cabeese/crab-tracker/README.md

# crab-tracker
Track invasive crab species via acoustic signals.
