cabeese/crab-tracker/doc/Template-RFC.tex

\documentclass[12pt]{article}

\setlength{\parindent}{0pt}
\setlength{\parskip}{2mm}

\usepackage{geometry}
 \geometry{
 letterpaper, left=20mm, right=20mm,  top=20mm,
 }
\usepackage{graphicx}
\graphicspath{ {graphics/} }
\usepackage{amssymb}

%%%%%%%%%%%%%%%%%%%%%%%%%%%%%%%%%%%%%%%%%%%%%%%%%
\title{RFC (n) - (Description)}
%%%%%%%%%%%%%%%%%%%%%%%%%%%%%%%%%%%%%%%%%%%%%%%%%

\author{
	Margot Maxwell \and
	Lizzy Schoen \and
	Noah Strong \and
	Chloe Yugawa
}

\date{\today\ -- v1.0-wip}

\begin{document}

\maketitle

\tableofcontents{}

\section{Introduction}

\section{Background}

\end{document}
