cabeese/crab-tracker/doc/TriangulationAlgorithm/triangulation_error.pdf

# Triangulation Error

Chloe Yugawa

June 2018

The below graph created from the data in the table show the error for algorithm output with different levels of precision. Data points are generated from -10 to 10 meters away from the center of the system along the x and y coordinates and from -3 to -10 meters along the z axis every half meter, generating over 25,000 data points. Time stamps are calculated in microseconds for each coordinate, and fed into the triangulation algorithm. The error graph includes percent of points where N, or distance from the middle of the hydrophones to the crab is off by more than 5 meters. N is used because it is less precise than angle measurement theta and both r and z are dependent on N. For microsecond errors (highlighted in red in the table, and on the left side of the graph), a random number between the positive and negative error listed in the table is added to each time stamp. At 0ns, the time stamps are precise down to the microsecond without regard for nanoseconds. Past that, data is precise up to the number of nanoseconds listed.

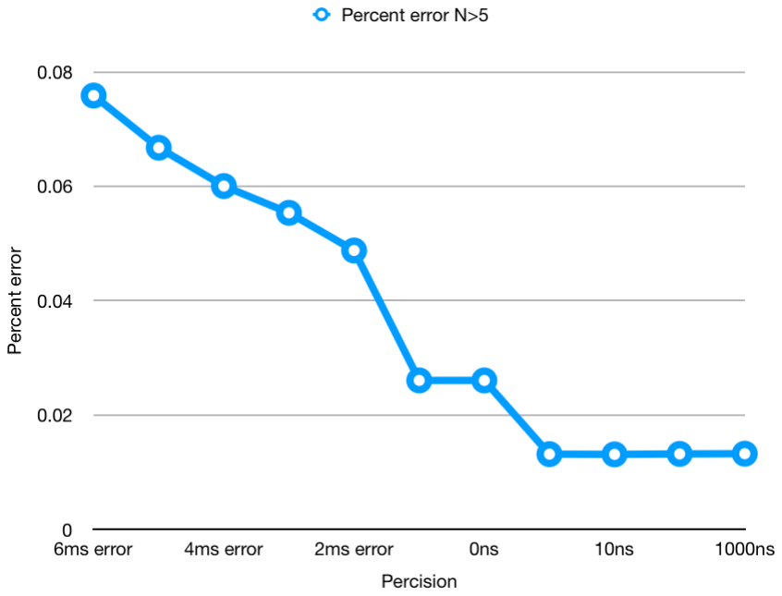
[picture p35: figure]

Figure 1: Graphed Error

Table 1: Error data
Precision | Percent error N>5
6µs error | 0.075868
5µs error | 0.066746
4µs error | 0.060044
3µs error | 0.055364
2µs error | 0.048780
1µs error | 0.026056
0ns | 0.026056
1ns | 0.013167
10ns | 0.013127
100ns | 0.013206
1000ns | 0.013246

1
