cabeese/crab-tracker/doc/TriangulationAlgorithm/TriangulationAlgorithm.pdf

# Triangulation Algorithm

Chloe Yugawa

February 2018

This algorithm is designed to calculate the location of a signal received by four hydrophones, all of which are equally spaced from each other in a square that is parallel to the surface of the water. To calculate the location of the signal origin, we will use the time stamps from each hydrophone (the time at which the signal was received), the speed of sound in the given environment, and some basic algebra and trigonometry. First, we write equations for the time it takes the signal to reach each hydrophone (labelled a,b,c, and d) using the formula for the distance between two points times the speed of sound in water (s). The origin is defined as the center of the hydrophone square, and l is defined as both the x and y distances from the origin to each hydrophone.
s = speed of sound through water
l = x and y distance from origin to each hydrophone
a = hydrophone at location (l, l)
b = hydrophone at location (−l, l)
c = hydrophone at location (−l, −l)
d = hydrophone at location (l, −l)
ta = time stamp of signal for hydrophone a tb = time stamp of signal for hydrophone b tc = time stamp of signal for hydrophone c td = time stamp of signal for hydrophone d

ta =

1
s

∗

p
(x − l)

2 + (y − l)

2 + z

2

tb =

1
s

∗

p
(x + l)

2 + (y − l)

2 + z

2

tc =

1
s

∗

p
(x + l)

2 + (y + l)

2 + z

2

td =

1
s

∗

p
(x − l)

2 + (y + l)

2 + z

2

Now, we define the deltas, or time differences. For this algorithm, hydrophone a has been chosen to be the reference. Calculating in terms of a different hydrophone would work equivalently.

delta1 = tb − ta =

1
s

∗

p
(x + l)

2 + (y − l)

2 + z

2 − s ∗

p
(x − l)

2 + (y − l)

2 + z

2

delta2 = tc − ta =

1
s

∗

p
(x + l)

2 + (y + l)

2 + z

2 − s ∗

p
(x − l)

2 + (y − l)

2 + z

2

delta3 = td − ta =

1
s

∗

p
(x − l)

2 + (y + l)

2 + z

2 − s ∗

p
(x − l)

2 + (y − l)

2 + z

2

These equations rewritten for clarity and for future steps:

delta1 =

1
s

(

p
(x + l)

2 + (y − l)

2 + z

2 −

p
(x − l)

2 + (y − l)

2 + z

2)

delta2 =

1
s

(

p
(x + l)

2 + (y + l)

2 + z

2 −

p
(x − l)

2 + (y − l)

2 + z

2)

delta3 =

1
s

(

p
(x − l)

2 + (y + l)

2 + z

2 −

p
(x − l)

2 + (y − l)

2 + z

2)

1

With 2s factored out and the distance to hydrophone a moved to the other side of the equations, we get:

delta1 ∗ s +

p
(x − l)

2 + (y − l)

2 + z

2 =

p
(x + l)

2 + (y − l)

2 + z

2

delta2 ∗ s +

p
(x − l)

2 + (y − l)

2 + z

2 =

p
(x + l)

2 + (y + l)

2 + z

2

delta3 ∗ s +

p
(x − l)

2 + (y − l)

2 + z

2 =

p
(x − l)

2 + (y + l)

2 + z

2

Squaring both sides and simplifying yields

(delta1 ∗ s)

2 + (x − l)

2 + (y − l)

2 + z

2 + delta1 ∗ s ∗

p
(x − l)

2 + (y − l)

2 + z

2 = (x + l)

2 + (y − l)

2 + z

2

(delta2 ∗ s)

2 + (x − l)

2 + (y − l)

2 + z

2 + delta2 ∗ s ∗

p
(x − l)

2 + (y − l)

2 + z

2 = (x + l)

2 + (y + l)

2 + z

2

(delta3 ∗ s)

2 + (x − l)

2 + (y − l)

2 + z

2 + delta3 ∗ s ∗

p
(x − l)

2 + (y − l)

2 + z

2 = (x − l)

2 + (y + l)

2 + z

2

Note that the only known values are the s and time stamps and thus the value of the deltas. Further simplification:
(delta1 ∗ s)

2 + delta1 ∗ s ∗

p
(x − l)

2 + (y − l)

2 + z

2 = 4lx | (1)

(delta2 ∗ s)

2 + delta2 ∗ s ∗

p
(x − l)

2 + (y − l)

2 + z

2 = 4lx + 4ly | (2)

(delta3 ∗ s)

2 + delta3 ∗ s ∗

p
(x − l)

2 + (y − l)

2 + z

2 = 4ly | (3)

Here, we see (2) is a linear combination of (1) and (3), and that the term p (x − l)

2 + (y − l)

2 + z

| 2 shows
up in all three equations. To solve this equation, set p (x − l)

2 + (y − l)

2 + z

2 = N.

(delta1 ∗ s)

2 + delta1 ∗ s ∗ N = 4lx | (4)

(delta2 ∗ s)

2 + delta2 ∗ s ∗ N = 4lx + 4ly | (5)

(delta3 ∗ s)

2 + delta3 ∗ s ∗ N = 4ly | (6)

Now, using the fact that the equations are linear combinations, we get (4) + (6) = (5):

(delta1 ∗ s)

2 + delta1 ∗ s ∗ N + (delta3 ∗ s)

2 + delta3 ∗ s ∗ N = (delta2 ∗ s)

2 + delta2 ∗ s ∗ N

Solving for N:

N =

s(delta²
2 − delta²
1 − delta²
3

)
2(delta1 + delta3 − delta2)

Solving (4) for x and (6) for y and using N which is now in terms of known values, we get

x =

(s ∗ delta1)

2 + 2s ∗ delta1 ∗ N
4l

y =

(s ∗ delta3)

2 + 2s ∗ delta3 ∗ N
4l

To find z, we go back to N =

p
(x − l)

2 + (y − l)

2 + z

2. We now have equations for N, x, and y, so we just need to solve this for z:
z =

p
N² − (x − l)

2 − (y − l)

2

The last calculations to do are translating the Cartesian coordinates into polar coordinates. Per the software requirements, angle measurements will be in degrees. z is the same in both coordinate systems, so the only values to find are radius r and angle θ.

r =

p
x

2 + y

2
θ = tanh ( y
x

) ∗

180
π

2
