cabeese/crab-tracker/GUI/radar.png

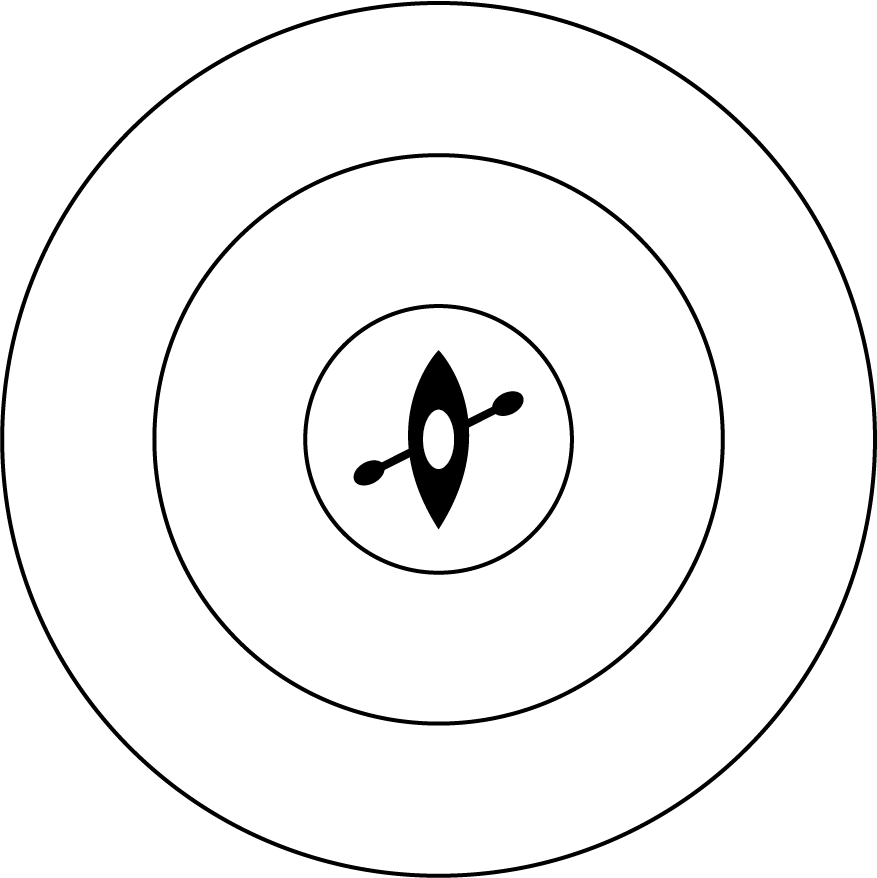
GUI/radar.png
