cabeese/crab-tracker/doc/TechnicalUserGuide/building.md

To create the glossary, first run PDFLaTeX, as usual.
Then, run
      makeglossaries main
Then run PDFLaTeX again.
