cabeese/crab-tracker/(threads)

Thread 2 (2017-11-04):

Statistical analysis - likelihood of collisions

cabeese, 2017-11-04:
We want to know the statistical likelihood of transmission collisions given various crab densities, broadcast encoding lengths, and interval lengths. We'd like to know how varying any one of these values affects the expected number of collisions within a given period of time.

For example, if we expect to have 3 crabs in the detection radius at any given time, what's the probability that two of them will transmit at the same time? (Where "same time" just means that their broadcasts interfere in any way.) How would that probability change if we extended the average time between broadcasts?

This seems related to the birthday problem:
https://betterexplained.com/articles/understanding-the-birthday-paradox/

It would be lovely to have a discussion of this in the RFC 1 document or else on its own somewhere.

chloeyugawa, 2017-11-29:
@cabeese Please add some sample numbers (e.g. interval time, etc.) so we can have some more-realistic calculations.

cabeese, 2017-12-14:
Here are some numbers that may be helpful and more in line with what we use in the project. Please forgive my shorthand notation.

### Rough estimates
* The **target listening radius** (aka the "**detection radius**") we're shooting for is about 50m.
* The **length of a signal**, from the rising edge of the first ping to the falling edge of the second ping, _is very much subject to change_ as the project progresses. However, for the time being, let's use the following numbers (derived below): 11ms to 1511ms.
* The **interval time**, defined as the time between consecutive broadcasts by a single transmitter*, is a randomly-varying value that will be recalculated between each broadcast. Currently, that value is expected to range between 20 and 30 seconds. _This, too, is subject to change_.

### Calculation of signal length
Pings should be a minimum of 1ms, and the space between rising edges must be no less than 10ms. The "step size" for ID encoding could be 0.1ms (see the equation below).

We'll assume `ping_duration = (1 + ID)ms` and `delay = (10 + 2*ID)ms`. Delay is calculated between rising edges, so one signal's length would be `ping + (delay-ping) + ping`, or just `ping + delay`. Therefore the min length of the whole signal would be `ping(0) + delay(0) = 1ms + 10ms = 11ms`, and the max (assuming a max id of 500) would be `ping(500) + delay(500) = 1ms + 500ms + 10ms + 2(500)ms = 1511ms`, or roughly 1.5 seconds.

### Footnotes
\* Footnote about the interval time: I think that this is defined as the time between the falling edge of one broadcast and the rising edge of the next, but it may be the time between the rising edges of two consecutive signals. However, for the sake of this document, I think it's acceptable to leave things ambiguous; the discrepancy in 'interval length' values between the two definitions is only 1.5 seconds, as we can see above.

cabeese, 2018-01-19:
Based on our recent discussions, it seems like an average of 30 seconds is a bit high for the interval time. What might it be like if we changed that range to be 7 to 13 seconds? (Something I'm just throwing out off the top of my head right now.)

31337H4X0R, 2018-01-19:
Ultimately I think that the interval time delay will depend on the
detection range; a larger detection range will result in more potential
collisions, so we may need to make the interval time longer just to avoid
unreasonably high collision probability. That, in turn, depends on basic
hardware testing that *should* be completed in the near future. I'll update
you all on that as soon as John and I get there. Since sound transmission
underwater is essentially lossless, I think that it will be quite hard to
keep the detection range as small as I want. So, I expect that the
detection range will be quite a bit more than 50m (just a gut feeling).

In the ideal scenario with low detection ranges those interval times all
sound reasonable to me. After thinking about it a bit, I don't think there
will be any reason to have an interval time less than 10-15 seconds

patrick

On Jan 19, 2018 10:45 AM, "Noah" <notifications@github.com> wrote:

Based on our recent discussions, it seems like an average of 30 seconds is
a bit high for the interval time. What might it be like if we changed that
range to be 7 to 13 seconds? (Something I'm just throwing out off the top
of my head right now.)

—
You are receiving this because you are subscribed to this thread.
Reply to this email directly, view it on GitHub
<https://github.com/cabeese/crab-tracker/issues/2#issuecomment-359054551>,
or mute the thread
<https://github.com/notifications/unsubscribe-auth/AgQDVqY3VsqHGqpCPGNHc9t_xUbnGsZwks5tMOLjgaJpZM4QR2tD>
.

cabeese, 2018-01-19:
Thanks for the input, Patrick! Great to hear your thoughts on that. To me, it sounds like our best bet for lowering the detection radius, should we need to, would be to decrease the power of the transmitters. Is that your feeling too? And how feasible is that with the hardware we're using? We could tune the integrators on the receivers to be less sensitive, but I think we could still run into issues with collisions from very distant transmitters that way. Those are just my gut feelings, too, though. I'm excited to see what we learn when we start testing all this stuff!

31337H4X0R, 2018-01-19:
I'm not sure whether adjusting the transmitter output or the triggering
threshold on the receiver would be better. I think we'll need to wait until
we get some data from prototype tests before we can move forward. I'm sure
John will have a more informative answer.

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

cabeese, 2018-01-21:
I realized I made some errors in those initial calculations. Specifically, I forgot a rather important decimal place. Here's some updated info which I shared with @chloeyugawa earlier.

Duration for each part of a UTP (see iCRAB Protocol Definition):
* `ping: (1 + 0.1*id) ms`
* `delay: (10 + 0.1*id) ms`
* `UTP: 2*ping(id) + delay(id)` (UTP is the full signal (ping, delay, ping))
* `inert_ping = (max_utp + delay(id) + ping(id)) ms` (method 4.3 only)

With these updated numbers, the upper bound on our UTP duration is much higher. If we encode boolean values via method 4.2 (see RFC 2), meaning that we use twice the number of IDs we expect to need and reserve half of them for "inert" crabs, our max broadcast duration will be **212 ms**. If we use method 4.3 (make the first ping really long if `inert = true`), the max broadcast duration is **323 ms**. These numbers assume that our biggest ID is 500 (which means we encode 1000 IDs in method 4.2).

31337H4X0R, 2018-01-21:
Did we ever discuss with John whether we can detect falling edges on the pings? We should bring this up in the meeting tomorrow (unless it's already been addressed and I'm just being forgetful).

Along the same lines, let's also run your idea for encoding the boolean by John tomorrow to keep him apprised of your thoughts on that.  Is it necessary to vary the length of both pings for collision detection? If we can get away with encoding ID redundancy in one ping, the second ping could be kept much shorter at all times and still be used to encode the boolean. This would decrease the probability of collisions by decreasing overall signal length.

cabeese, 2018-01-22:
I believe we confirmed that we can detect falling edges. @mimaxwell, can you confirm? In your `READ_PIND` code you were able to read everything, right? As I remember, you can read any pin at any time and it returns a `0` or a `1`, so we can detect a `1 -> 0` transition (aka a falling edge).

As far as varying the second ping length, I'd have to give that some more thought to be absolutely sure one way or another. I don't remember off the top of my head if we will run into issues if the second ping is a fixed length. However, at this point I'm not too worried about shaving off time from the UTPs. If transmissions are ~0.2 seconds and they occur every 10-20 seconds, for example, I think collisions are still going to be fairly infrequent given our density estimates. @chloeyugawa has been working on new statistics with some updated numbers, so we'll be able to quantify "fairly infrequent."

chloeyugawa, 2018-03-20:
Closed by #42

Closed 2018-03-20.

Thread 4 (2017-11-12):

Read Data from Pins on Arduino

cabeese, 2017-11-12:
## Background

We want to be able to read the input pins on our new Arduino Nano. Each time the state of any pin changes from HIGH to LOW or vice versa, we should note the timestamp and store a "snapshot" of all pins at that moment. For now, we'll keep this data in an array somewhere in memory; this array will eventually be transmitter to another computer.

Reading from the pins must be extremely fast so that our results are consistent and accurate. As such, we cannot use the built-in read functions; instead, we must directly read from the registers containing the pin states.

## To Do

* [ ] Read input state on 4 or more pins (from registers).
* [ ] Detect when the state of any pin changes (XOR w/ previous state).
* [ ] When any pin changes, store the current timestamp and the pin states in an array.
* [ ] If the array is full, start back at the beginning and overwrite data. For now, we'll assume that data is transferred away quickly enough that this won't cause a problem, but we should reexamine this at some point in the future.

## Resources

* [Arduino - Port Registers](https://www.arduino.cc/en/Reference/PortManipulation)
* [Nano Pinout Diagram (PDF)](http://www.pighixxx.com/test/pinouts/boards/nano.pdf)
* [How to control arduino pins from registers without digitalWrite and digitalRead](http://www.eprojectszone.com/2016/07/30/how-to-control-arduino-pins-from-registers-without-digitalwrite-and-digitalread/)

Closed 2017-12-02.

Thread 5 (2017-11-12):

Transfer Data from Arduino to Pi via SPI

cabeese, 2017-11-12:
## Background

There are two possible ways to communicate between the Arduino and the Raspberry Pi Zero: via a serial connection over USB, and via SPI on the pins of both boards. Because of the limited number of USB ports on the Pi, and because SPI is significantly faster than serial, we are initially going to attempt to implement an SPI connection between the two devices.

## To Do

* [x] Implement basic message passing from Arduino to the Pi
* [ ] Determine the overhead/delay incurred from sending a message
* [ ] Is it somehow possible for the slave to send an interrupt to the master?

## Resources

* [Arduino SPI Reference Documentation](https://www.arduino.cc/en/Reference/SPI)
* [Nano Pinout Diagram (PDF)](http://www.pighixxx.com/test/pinouts/boards/nano.pdf)
* [pinout.xyz SPI](https://pinout.xyz/pinout/spi) and [pinout.xyz Pi Zero](https://pinout.xyz/pinout/io_pi_zero)
* [Pi Zero Pinout (image)](http://pi4j.com/images/j8header-zero-large.png)

cabeese, 2018-01-03:
It looks like we can get some simple SPI going based on sample code/tutorials posted online. A basic SPI connection between the two devices doesn't look to be too complicated, and @mimaxwell has successfully passed messages from the Arduino to the Pi. Some of that code exists already under the `hello` project in the `ISSUE5` branch.

The tricky step moving forward will be to integrate SPI with our pin reading. Because SPI is synchronous (clock-based), we have to make sure that the Arduino does not get ahead or behind the master (pi) clock while simultaneously scanning the input pins. Theoretically, this sounds simple; I just hope it doesn't get too much more difficult in practice.

Another consideration with SPI is that the master (the pi) must initiate the read/write. That means that it will need to poll the Arduino periodically to check for new data. From what I've read, it is possible to handle SPI in an interrupt service handler, but I think this may only apply to the slaves. I'll add this to the task as something to research, though, as it would be really nice if the Arduino could interrupt the Pi when it gets new data.

@mimaxwell and I hope to have some basic message passing working before the start of the quarter. This would mean working code for both devices that goes a step or two beyond the demo code, and that we both understand. Once the quarter gets underway, we can expand on this and integrate it with the code that reads the pins.

cabeese, 2018-01-28:
Given that we had mixed results with the Pi 0 and are instead moving to a Model B, I'm going to move this to a future milestone so that we can ensure SPI works with our new (and hopefully final) hardware setup.

cabeese, 2018-02-03:
Demo code has been uploaded. I think the "Read_PIND" and SPI code should be combined in a separate issue + branch.

Closed 2018-02-03.

Thread 9 (2017-12-21):

Research possibility of encoding boolean value in transmissions

cabeese, 2017-12-21:
# Background

Our client has requested that we look into adding the ability for a transmitter to broadcast some additional detail about the crab it is paired with. Specifically, Patrick is interested in attaching accelerometers to the tagged crabs so that we can determine if a given crab is "inert," perhaps because it has molted its shell or because it has died. We would encode this as an additional binary value in the transmission signal.

**Edit 2017-12-25:**
Note that some terminology used in this document is defined in RFC2, which currently lives on a different branch from the branch where work on this document is taking place. See the [`6-uid-encoding-documentation`](https://github.com/cabeese/crab-tracker/compare/6-uid-encoding-documentation) branch to read RFC2's glossary of terms.

# Requirements

We want to be able to encode both a UID and some binary value in each transmission without losing the work we've done to ensure that all collisions are detectable. Additionally, in the event that we decide not to include this feature in the final product, the changes made to the iCRAB protocol must not interfere with our original goals. That is, if we scrap this requirement, it should cost little or no extra work to continue on our original path.

# TODO

* [x] Create an RFC detailing the problem
* [x] Include potential solutions in the RFC
* [x] Solicit feedback on said solutions and decide on one
* [ ] Incorporate this solution into the iCRAB protocol definition

cabeese, 2018-01-13:
Based on team discussions, we have decided to adopt "Method 4.2," in which we effectively double the number of IDs we encode and reserve half of them for use only when the boolean value is `true`. RFC-2 will be updated to reflect this and then these changes will be integrated into the official iCRAB protocol definition document.

Closed 2018-01-13.

Thread 12 (2018-01-13):

Directional Vector Algorithm Implementation

cabeese, 2018-01-13:
# Background

We have established a means of "triangulating" transmissions based on the arrival time of a signal at the various receivers. Once it has been formally written up (see #3), we will implement and test it.

# Requirements

Once Issue #3 is completed, we should implement _and test_ the algorithm in either C or C++. The implementation can assume that the function will be called only when there is sufficient data for running a calculation. That is, at least one ping (rising edge) has been detected by each of the receivers in the receiving array. (It will be up to other code, yet to be implemented, to determine when enough data has been received as it comes in in real time.) However, the algorithm should be able to detect anomalous or otherwise invalid data points and return a meaningful error.

One possible suggestion is to create two functions. One takes as arguments only the timestamps of the rising edges of pings for each of the four receivers and performs the actual calculation. The other function would act as a wrapper and would extract the timestamps from the `ping` structs that contain the raw state information. The motivation for doing this is that the `ping` struct is not yet fully defined and may change in the coming weeks, and it would be much easier to adjust the wrapper function than to fuss with the internal logic of the primary algorithm if/when these changes occur.

Consider these *example* prototypes:
```C
/**
 * Wrapper function for directional vector calculation.
 * First argument(s) point to "ping" or similar structs
 * 'result' is an out parameter and is a matrix (or other)
 */
int dirvec( /* 'ping' arguments TBD, */ matrix_t *result);

/**
 * Directional Vector algorithm. Does actual direction calculation.
 * 'ts_a' is the timestamp of a ping arriving at receiver A
 * 'ts_b' is the timestamp of a ping arriving at receiver B
 * ...
 * 'result' is an out param
 */
int dirvec_helper(int ts_a, int ts_b, int ts_c, int ts_d, matrix_t *result);
```

Again, these are simply suggestions and not formal requirements of function prototypes.

# Deliverables/TODOs

* [ ] Establish and define a type/struct for the return/result value (e.g. 2D vector, degree int offset from a given receiver, etc), including error case(s)
* [x] Implement the core of the algorithm
* [x] Write test cases and verify correctness under "normal" (valid) circumstances
* [x] Ensure algorithm reports an error when the input is invalid (indicating that there was a collision, or timestamps from a different event got mixed in, or any other potential cases)

cabeese, 2018-04-06:
@cabeese will now review the code as it stands now and prepare to merge it into `master`. When it's ready to go, @chloeyugawa will review it, and then it can be merged.

Closed 2018-06-06.

Thread 13 (2018-01-13):

Research unit testing in C/C++

cabeese, 2018-01-13:
# Background

Especially for components such as our directional vector algorithm, we want to ensure that our code performs as expected when given various input. However, none of us are familiar with standard "unit testing" methods for C/C++ development. We'd like to know common practices so that we can establish consistent testing methods across the project.

# Requirements

Figure out good or common methods for writing and running unit tests in C/C++ and document these somewhere (as comments to this issue, documents or samples in the repo, etc.).

enalaiya, 2018-01-19:
There are several good frameworks for this - we should just pick one.
Check or cUnit seem good!

cabeese, 2018-01-19:
Are there any striking differences between the two?

A couple of others that look promising:
* https://github.com/cpputest/cpputest Aimed at Embedded Systems devs, but it looks like a nice interface
* https://github.com/google/googletest New and actively developed by Google

cabeese, 2018-02-11:
Ohhh, this looks cool! https://github.com/catchorg/Catch2

Never seen it before. Looks lightweight and really easy to get into. I may start using it for my code.

cabeese, 2018-02-20:
I've made some unit tests with [Catch2](https://github.com/catchorg/Catch2) and I'm really liking it. I suggest that we move forward with it for the time being. I'm closing this issue for the sake of the deadline tonight, but we can revisit this topic later if we feel that Catch2 isn't able to provide us with everything we need.

Closed 2018-02-20.

Thread 14 (2018-01-13):

Design and Implement UID Decoding Algorithm

cabeese, 2018-01-13:
# Background

As seen in #6, we have a protocol by which transmitters may identify themselves. Each transmitter can encode its unique ID (UID) in every transmission pattern (UTP) that it broadcasts. We'd like to be able to decode the incoming signal and determine the UID of the broadcasting transmitter.

# Requirements

This solution must be able to reliably decode the ID of a given transmitter, even if measurements by the receivers are not perfectly precise. It must verify that the signal read in is valid and hasn't been interfered with in any way. Recall that the iCRAB protocol encodes each UID in three separate parts of the UTP signal: the duration of the two pings and the duration of the delay. Should any one of these durations not agree with the others, the algorithm must report an error condition, potentially indicating that a collision occurred if that is indeed suspected.

Finally, the algorithm must also handle boolean value encoding in the signal, as described in RFC 2 and the iCRAB Definition documents. The algorithm must return as distinct parts the UID and the boolean value that are encoded in the broadcast.

The algorithm must fully comply with the specifications detailed in the iCRAB Protocol Definitions document in order for this issue to be considered complete.

# API

We should expose two functions for UID decoding: one decodes the ID encoded in a single ping, the other decodes the ID encoded in the delay between two pings.

The input for both methods will be a `ping` struct, which contains three pieces of information: `pin`, `start (us)`, and `duration (us)`. This struct is defined in `src/pi-src/data_collection.h`.

**NB:** The timing values may not be exact, so we should defined some threshold (e.g. +/-0.01 ms) of variability to allow for the fact that the timing values may not be exact. That is, while we may expect the duration of a given ping to be 1.25ms, it may actually be measured as 1.241ms.

### Exposed Functions

```C++
/**
 * Determines the ID encoded in a single ping's duration.
 *
 * Will calculate ID based on
 *     p.duration
 * while also accounting for slight discrepancies in timing values.
 *
 * @param p - The ping to decode
 * @returns The ID encoded in 'p'
 */
int id_decode_ping(ping p);

/**
 * Determines the ID encoded in the delay between two consecutive pings.
 *
 * Will calculate ID based on
 *     b.start - (a.start + a.duration)
 * while also accounting for slight discrepancies in timing values.
 *
 * @param a - The first ping (in chronological order)
 * @param b - The second ping (in chronological order)
 * returns The ID encoded by the time between 'a' and 'b'.
 */
int id_decode_delay(ping a, ping b);
```

# Deliverables/TODOs

* [x] Determine the out parameters and/or return value(s). ---> See prototypes above
* [ ] Implement and test basic UID decoding.
* [ ] Implement and test boolean value decoding. (Not described above - yet)
* [ ] Ensure that collisions and other anomalies are reliably detected. (Not described above - yet)
* [ ] Ensure that some amount of timing variance within a reasonable threshold is accepted.

Closed 2018-03-27.

Thread 15 (2018-01-13):

Specify Data Formatting, Polling, Etc.

cabeese, 2018-01-13:
# Background

There now exist many issues for the larger components of the project, such as triangulation and data communication between devices. However, there still exist many gaps to bridge. This issue serves as a bit of a "catch-all" for some/many/all (TBD) of these gaps.

Many of the things listed here are important in integrating the various components of the system as we work towards a functional prototype.

# Data Formatting (Originally from #3)

## Background

As we begin development on our triangulation and UID decoding algorithms, we should ensure that we have a clear picture of how the data will be formatted on the central machine. Because the data will arrive on the machine "randomly" (i.e. not in cohesive sets of 4 pings), we must formulate a method of determining when we have enough data points to begin running a calculation.

This writeup assumes that we have two physically separate devices coordinating in the system. One, the "processing machine," detects raw input from the hydrophones and collects highly-accurate timestamps whenever a rising (or falling) edge is detected. This data is then passed to the "central machine," which examines timestamped data as it comes in and runs triangulation, collision detection, and UID decoding algorithms. In the future, this machine will likely be responsible for sharing this processed information with the user in a matter yet to be determined. Currently, these machines are an Arduino Nano and a Raspberry Pi Zero, respectively.

## Data Formatting

Based on our meeting with EE on 11-08, here's how we expect the data to be formatted:

```C
struct state {
    int timestamp; // timestamp associated with this data point
    short states; // the state of every pin/hydrophone
}
```

Each time a state change is detected by the processing computer (that is, each time a rising or falling edge occurs on one or more of the pins), a new "state" object is generated and sent to the central computer. The state object, shown above in C, contains a timestamp and a representation of every pin at at that moment. In this case, a 1 (HIGH) in a given index indicates that the receiver associated with that index is detecting a signal. Similarly, a 0 means that no audio signal is detected by a given receiver. As an example, the pattern `0010` would indicate that only the 3rd receiver could "hear" anything at that moment.

Let's assume that we have some amount of memory allocated for the pings as they come in; that is, we'll have an unsorted array of `ping`s that is filled up as data comes in. We should clean this out as we finish calculating the data.

# Requirements

So far, the major "gaps" that have been identified include:
* Data formatting on the Pi
* A method for determining when and/or how to retrieve data from the Arduino
* A method for determining when the Pi has enough data to begin various calculations (e.g. calling the directional vector or UID decoding algorithms)

This list should be updated as additional requirements are identified and/or existing problems are solved or moved into their own issues.

cabeese, 2018-02-15:
Much of this has been moved over to #34. However, these items still remain:
- Determine polling frequency (adjust based on incoming data? May want to poll frequently when data is coming in and less frequently during anticipated "intervals" between transmissions.)
- Determine when there is enough data to detect direction, collisions, etc.

cabeese, 2018-05-27:
The remainder of these issues were settled in #51. Closing this issue

Closed 2018-05-27.

Thread 18 (2018-01-17):

Research and Determine RasPi Hardware Requirements

cabeese, 2018-01-17:
# Background

Currently, we are working with Raspberry Pi Model Zeros for our development. While this has been sufficient thus far (some outstanding SPI issues not accounted for), we may need to upgrade to more powerful hardware to accommodate the small touch screen that we would like to add to the project. We'd like to know if the combination of the screen and the precise timing needed for SPI will require more powerful hardware.

# Requirements

* Determine what kind of resources will be needed to display something on a small SPI-connected Pi screen. (Bonus/possibly prerequisite: will we need to boot into a full GUI-based OS to work with the screen, or can we draw to it manually with SPI somehow?)
* Compare the specs of a standard RasPi and the Zero. How much faster is the processor on the larger model? What other considerations should we take into account?
* Determine if using the screen while also requiring some amount of *reliable* (though potentially slow) performance from the board is possible on the Zero or if we'll need to buy a larger version.

The various available models are viewable [here](https://www.raspberrypi.org/products/).

mimaxwell, 2018-01-21:
Decided to use a raspberry pi touch screen and the raspberry pi 3 b that is recommended to connect with it:

-  While it's possible to use a pi zero and a touch screen, connecting a pi 3 b to the raspberry pi touch screen is a standard configuration. There's lots of guides and online support that can provide aid if we need it.

-  The raspberry pi 3 b does not communicate with the pi screen using SPI, which will simplify using SPI to communicate with the Arduino.

- The quad core of the pi 3 b will allow the various portions of the system to run in different threads. The pi zero has only a single core.

Closed 2018-01-21.

Thread 23 (2018-01-28):

Document Arduino setup

mimaxwell, 2018-01-28:
Create documentation that explains how to properly wire the  Arduino input pins.

cabeese, 2018-06-07:
Wiring diagram included in the _Technical User Guide_ document. Closing this issue

Closed 2018-06-07.

Thread 28 (2018-02-03):

Pass 'pin_d'-style data to Pi via SPI

cabeese, 2018-02-03:
# Background

We have demo code working that transfers sample data from the Arduino to the Pi. However, we'd of course like to transfer our own real data. This will require some experimenting, data reformatting, etc.

# Requirements

* [x] Pass data in the format we need (as `(state, timestamp)` pairs)
* [x] Instead of looping forever, the Pi should initiate reads when we tell it to
* [x] Ability to send flag to Arduino (such as `RESET`)

Closed 2018-02-11.

Thread 31 (2018-02-07):

Connection Test: Generator -> Arduino

cabeese, 2018-02-07:
# Goal

Ensure that the data sent by the pulse generator to the Arduino is read correctly and accurately.

# Tests

* [ ] Send data on each of the pins individually, and ensure that the pin mapping is what we expect.
* [ ] Send pattern on one pin and decode on Arduino. Does this match what was sent? That is, can we measure the ping duration that the pulse generator sent?
* [ ] Send pattern to two pins (identical). Does the input on both pins match? Does it match what we sent?
* [ ] Send pattern on two pins with some time offset. Measure time offset on rising edges of two pins. Does that gap match the expected gap?

cabeese, 2018-03-14:
Some of this was effectively completed in #34 and #40.

@mimaxwell could we move all of this code into a test code directory? Perhaps `/hardware-tests` or something. Then we can go ahead an open a PR. Thanks!

Thread 34 (2018-02-11):

Collect and parse data on Pi

cabeese, 2018-02-11:
# Background

We can transmit raw data to the Pi via SPI, but that data is not stored or processed into `struct`s that are useful for other parts of the program.

> Note: part of this issue description, including some TODO items (checkboxes), disappeared completely from this issue.

# Requirements

* [x] Create a `struct` that will suit the needs of the other elements of the program (such as direction detection and UID decoding)
* [x] Parse and store the raw SPI data into the structs described above
* [x] Implement SPI echo/test call and response
* [x] Add some printing for testing and prototyping
* [x] Write unit tests
* [x] Finish full integration testing with pulse generator/simulator

Closed 2018-02-28.

Thread 37 (2018-02-23):

Bring up Digital Compass

cabeese, 2018-02-23:
# Background

Collectively, we determined that a magnetic compass is necessary in order to make this program more usable. We have since purchased two such chips and we'd like to add headers and wire them up.

Potentially useful guide: http://ozzmaker.com/compass1/

# TODOs

* [x] Solder headers on both boards
* [x] Create jumpers
* [x] Connect the boards to the Pis
* [x] Ensure that the screen and the compass are configured properly to be addressed individually over I2C - that is, both devices can be used at once without interfering with each other.

mimaxwell, 2018-03-11:
Needed to:
sudo raspi-config
select option 5 Interfacing Options
go to P5 I2C and press enter
A screen will pop up that asks "Would you like the ARM I2C interface to be enabled?" select <Yes>
Select <Ok>
Select <Finish>

vim  /etc/modules
add the line i2c-bcm2708

vim /boot/config.txt
uncomment or add the lines
dtparam=i2c1=on
dtparam=i2c_arm=on

sudo reboot

i2cdetect -y 1

Currently the pi won't recognize the screen and the compass at the same time

cabeese, 2018-03-14:
@mimaxwell Looks great. Please add this to a new MarkDown (`.md`) file in the `doc/` folder and then submit a PR

mimaxwell, 2018-03-26:
https://github.com/cabeese/crab-tracker/pull/44

cabeese, 2018-04-06:
Closed by #44.

Closed 2018-04-06.

Thread 40 (2018-03-01):

SPI Stability and Performance Improvements

cabeese, 2018-03-01:
# Background

SPI data transmission is unstable when we test it. This is hopefully due to the fact that the Pi does not pause between byte transmissions.

Additionally, there are a few improvements to the Arduino code that may speed it up by a few clock cycles each time it loops.

# Requirements

### Arduino
* [ ] Fix `DDRD` setting (should be done in hotfix/feb-25 branch)
* [ ] Move the `timestamp` calculation into the body of the `if` statement

### Pi
* [ ] On the Pi, add a delay between each call to `spi_getbyte()` in `spi_getblock()`
* [ ] Stress test and adjust the sleep time as needed. Start with 10us and see if that can be lowered even when a huge amount of data is sent at the arduino

cabeese, 2018-03-22:
I think I have identified the remaining issue regarding the seemingly "random" erroneous data that comes through via SPI occasionally.

## The setup

The pulse generator is sending 100us pings, one on each pin, with a delay of 200us between consecutive pings. (That is, the first pin goes high for 100us, then, 200us after it goes low, the second pin goes high, and so on.) There is a slightly longer wait after all four pins have pinged before the loop repeats. (Currently, it is 700us, for what that's worth.)

The pings are measured on the Arduino and sent to the Pi. The Pi displays the data.

## The problem

Occasionally, we will measure a `ping` (on the Pi) as being very, very long. Often about 8 times longer than it should be in a few examples that I looked into. That is, rather than being 100us, it is closer to 5.6 million us, or 5.6 seconds.

## Observations

* Often, it seems that the measured duration is _consistently_ larger. For example, when running the program at one time, all extra long pings have a duration of `0x55b2nn`, where `nn` is some number normally close to `0x80`. This is consistent across all long pings. However, after quitting and restarting (perhaps after making changes to the binary, though this is not confirmed), the durations then become `0x156cnn`. Again, these numbers are real-life examples but not necessarily mean anything.
* Increasing the length of the bounded buffer on the Arduino reduces the frequency of these bad data points.
* Decreasing the length of the bounded buffer on the Arduino increases the frequency of these bad data points.
* The affected pin (that is, the pin which reports to have measured an extremely long ping) is always the same for a given run of a program. In recent memory, in fact, it always seems to be pin 0, but I can't confirm that it is never another pin.
* There are many good data points (on all pins, including the "misbehaving" one) between two bad measurements.
* In my observations, when a bad ping is measured, its end timestamp (when the pin went low) looks valid (that is, it is generally close to 200us before the next ping starts) but the start timestamp is much, much earlier than expected.
* In general, the suspicious timestamp is one that has not been recorded before.

## Example(s)

```
LONG PING DETECTED.	start: 67535248 (0x4068190)	end: 73151504 (0x45c3410)
== PING == pin: 0	start: 67535248 (0x4068190)	duration: 5616256 (0x55b280)
== PING == pin: 1	start: 73151704 (0x45c34d8)	duration: 100 (0x64)
== PING == pin: 2	start: 73152012 (0x45c360c)	duration: 96 (0x60)
== PING == pin: 3	start: 73152312 (0x45c3738)	duration: 100 (0x64)
. . . many data points omitted . . .
LONG PING DETECTED.	start: 73151404 (0x45c33ac)	end: 78767668 (0x4b1e634)
== PING == pin: 0	start: 73151404 (0x45c33ac)	duration: 5616264 (0x55b288)
== PING == pin: 1	start: 78767868 (0x4b1e6fc)	duration: 100 (0x64)
== PING == pin: 2	start: 78768172 (0x4b1e82c)	duration: 100 (0x64)
== PING == pin: 3	start: 78768476 (0x4b1e95c)	duration: 96 (0x60)
```

Notice how when a "long ping" is detected, the end timestamp is similar to the start timestamp of the next ping, but that the start timestamp of the bad ping is much earlier than it should be.

## Possible source(s) of the problem

One guess that I have currently is that the "write" (when pinval changes are detected) head of the bounded buffer is catching up with the "read" (SPI) head. We are always careful not to let the SPI head pass the "write" head, as this could potentially lead us to read a bunch of garbage data. However, we do nothing to prevent the "write" head from "lapping" the SPI head. So, it is possible that an SPI transfer is initiated but that as this is happening, the bounded buffer fills completely and new data is written to the location that the SPI/read head is pointing at. Thus the data being sent is overwritten as it is being transferred into the SPI data register, so part of it is old and part of it is brand new, and all of it is totally junk.

I'll try to elaborate on this more, and attempt a fix, when I get a chance later.

cabeese, 2018-03-23:
After some further investigation, I still haven't been able to pinpoint the problem, though I have found some new information.

* The problem appears to have something to do with the bounded buffer looping over to a single, specific element. For example, if the bounded buffer size is set to 8, the long pings seem to occur only when part of their measurement is stored in `buffer[0]`.
* If the buffer is of length 64, the problem is very infrequent, happening about once every 4 minutes with the simulator configuration mentioned in the above comment.

cabeese, 2018-04-26:
As of the time of this writing (and commit fc5ffd2), the bug detailed above is still at large. However, at this point, my priorities need to change, so for now I think we should move ahead and come back to this at some point later on. Fortunately, the problem does not occur very frequently when the bounded buffer on the Arduino is of size `64`.

I will create a new issue for the remaining bug and open a PR for the work that has been done.

Thread 53 (2018-04-26):

Occasional hiccup in SPI data

cabeese, 2018-04-26:
# Background

While working on #40, the Pi would occasionally report pings with extremely long durations. Some investigation was done into the issue, but after many failed attempts to solve the problem, it was determined that this bug was a lower priority than some of the other mandatory features of the program. Note that when the bounded buffer on the Arduino is large (e.g. 64 entries long), the problem does not occur frequently.

# Problem

For more details, see the comments in #40.

Thread 55 (2018-04-28):

Port "data collection" code to Teensy 3.5

cabeese, 2018-04-28:
# Background

The overhead of the main loop combined with the fact that the Arduino Nano runs at 16MHz means that it is not well suited to the job of collecting and timestamping incoming data, as the device will not accurately and precisely record timestamps. Therefore, we are going to instead attempt to use a Teensy 3.5, which runs at 130MHz. We will also try to optimize or otherwise refactor the code to produce more reliable, accurate, and precise timestamps (for instance, by directly reading from one of the clocks on the device).

cabeese, 2018-06-16:
In case we continue down this road, the following posting has some information about SPI on the Teensy: https://forum.pjrc.com/threads/48749-I2C-SPI-ESP-webSockets-controller-for-teensy

Thread 56 (2018-05-15):

Create a Technical User Guide

cabeese, 2018-05-15:
# Background

Given the complexity of the project, future contributors may have difficulty understanding the various components simply by viewing our current documentation and source code.

# Requirements

The aim of this issue is to create a technical guide to the project that details various components, including:

* The project overview
* Computer hardware choices and rationale
* Custom hardware design
* Structure of software
* Opportunities for future modifications

This list of requirements may be updated based on @31337H4X0R's comments.

Closed 2018-06-05.
