cabeese/crab-tracker/src/pi-src/config.h

/******************************************************************************
Program configuration

Adjust various elements of the program's behavior. This file may be replaced
with an alternate means of configuration as we see fit in the future.

Author:  Noah Strong
Project: Crab Tracker
Created: 2018-02-22
******************************************************************************/

#ifndef __CONFIG_H
#define __CONFIG_H

#define CONFIG_FILE_PATH "/etc/crab-tracker.conf"

#endif /* __CONFIG_H */
