cabeese/crab-tracker/src/pi-src/uid.cpp

/******************************************************************************
Decodes unique identifiers from transmissions

The details of UID encoding and decoding can be found in the iCRAB Protocol
documentation (TransmissionProtocol.pdf).

Note that we expect some amount of noise or variance in our measured signals,
so we can't rely on the measured durations or delays matching perfectly with
our mathematical expectations. To compensate for this, we simply round each
decoded ID (as a float) to the nearest integer. This way, if a given duration
is 0.074ms longer than it "should be" based on our documentation, the small
error is thrown away.

Author:  Noah Strong
Project: Crab Tracker
Created: 2018-02-28
******************************************************************************/
#include <math.h>
#include "uid.h"

/**
 * Determines the ID encoded in a single ping's duration.
 *
 * Will calculate ID based on
 *     p.duration
 * while also accounting for slight discrepancies in timing values.
 *
 * @param p - The ping to decode
 * @returns The ID encoded in 'p'
 */
int id_decode_ping(ping p){
    float duration_ms = p.duration_us / 1000; /* convert us->ms */
    float raw_id = (duration_ms - MIN_PING_DUR_MS) / STEP_SIZE_MS;

    return (int)roundf(raw_id);
}

/**
 * Determines the ID encoded in the delay between two consecutive pings.
 *
 * Will calculate ID based on
 *     b.start - (a.start + a.duration)
 * while also accounting for slight discrepancies in timing values.
 *
 * @param a - The first ping (in chronological order)
 * @param b - The second ping (in chronological order)
 * returns The ID encoded by the time between 'a' and 'b'.
 */
int id_decode_delay(ping a, ping b){
    float delay_ms = ((float)(b.start_us - (a.start_us + a.duration_us))) / 1000; /* us->ms */
    float raw_id = (delay_ms - MIN_DELAY_DUR_MS) / STEP_SIZE_MS;

    return (int)roundf(raw_id);
}
