cabeese/crab-tracker/src/pi-src/test_direction.cpp

#include <iostream>
#include <fstream>
#include <stdlib.h>
#include <math.h>
#include <algorithm>
#include <vector>
#include <stdio.h>
#include <time.h>

#include "direction.h"
#define R 1 /*  "r"  the length of the hydrophone square          */
#define R_USER 1
#define _ENABLE_RANDOM_TIME_NOISE 1 /* 1 to add +/-6us to timestamps, else 0 */

const double S_USER = 1.5/1000;
using namespace std;


typedef struct {
  double x;
  double y;
  double z;
  double N;
  double r;
  double theta;
} detailed_crab_event;

typedef struct {
  double ts_a;
  double ts_b;
  double ts_c;
  double ts_d;
} timestamps;

typedef struct{
  unsigned long ts_a;
  unsigned long ts_b;
  unsigned long ts_c;
  unsigned long ts_d;
} actualTime;

/* PROTOTYPES */
int calcDist(double x, double y, double z, detailed_crab_event *result, timestamps *times);
void printTimes(timestamps *times);

void convertTimestamps(timestamps *times, actualTime *actual);
void difference( detailed_crab_event *actual, crab_event *result, detailed_crab_event *diffResult);
/* END PROTOTYPES */

/*
 * Helper functions calculate various calculations
*/

int main(int argc, const char* argv[]) {
  detailed_crab_event actual;
  timestamps actualTimes;
  actualTime intTimes;
  crab_event result;
  detailed_crab_event diffResult;
  double x1;
  double x2;
  double x3;
  double y1;
  double y2;
  double y3;
  double z1;
  double z2;
  double z3;
  double N1;
  double N2;
  double N3;
  double r1;
  double r2;
  double r3;
  double t1;
  double t2;
  double t3;
  int goodcount = 0;
  int badcount = 0;
  // Error is between 1-5m off for abs(N) etc
  int error1 = 0;
  int error5 = 0;
  int error10 = 0;
  int error20up = 0;
  std::ofstream output;
  output.open ("data.csv");
  output << "x,y,z,N,r,theta,calcX,calcY, calcZ,calcN,calcR,calcTheta, difX,difZ,difY,difN,difR,difTheta\n";
  for (double i = -10.0; i <= 10.0; i += 0.1) {
    for (double j = -10.0; j <= 10.0; j += 0.1) {
      for (double k = 3.0; k <= 10.0; k += 0.1) {
        x1 = i;
        y1 = j;
        z1 = k;
        calcDist(x1, y1, z1, &actual, &actualTimes);
        N1 = actual.N;
        r1 = actual.r;
        t1 = actual.theta;
        convertTimestamps( &actualTimes, &intTimes);
        unsigned long ts_a = intTimes.ts_a;
        unsigned long ts_b = intTimes.ts_b;
        unsigned long ts_c = intTimes.ts_c;
        unsigned long ts_d = intTimes.ts_d;
        if(_ENABLE_RANDOM_TIME_NOISE){
            ts_a += (rand() % 6 + -6);
            ts_b += (rand() % 6 + -6);
            ts_c += (rand() % 6 + -6);
            ts_d += (rand() % 6 + -6);
        }
        triangulation_helper(ts_a, ts_b, ts_c, ts_d, &result);
        // TODO: what should we do about these values? They don't exist in a 'crab_event' struct
        x2 = y2 = 0;
        // x2 = result.x;
        // y2 = result.y;
        z2 = result.z_m;
        N2 = result.N;
        r2 = result.r_m;
        t2 = result.theta;
        difference(&actual, &result, &diffResult);
        x3 = diffResult.x;
        y3 = diffResult.y;
        z3 = diffResult.z;
        N3 = diffResult.N;
        r3 = diffResult.r;
        t3 = diffResult.theta;
        if ((abs(N3) > 1) && (abs(N3) < 5)) {
          error1++;
          //badcount++;
          goodcount++;
          output << x1 << "," << y1 << "," << z1 << "," << N1 << "," << r1 << "," << t1 << "," <<
          x2 << "," << y2 << "," << z2 << "," << N2 << "," << r2 << "," << t2 << ","
          << x3 << "," << y3 << "," << z3 << "," << N3 << "," << r3 << "," << t3 << std::endl;
        } else if ((abs(N3) > 5) && (abs(N3) < 10)) {
          error5++;
          badcount++;
          output << x1 << "," << y1 << "," << z1 << "," << N1 << "," << r1 << "," << t1 << "," <<
          x2 << "," << y2 << "," << z2 << "," << N2 << "," << r2 << "," << t2 << ","
          << x3 << "," << y3 << "," << z3 << "," << N3 << "," << r3 << "," << t3 << std::endl;
        } else if ((abs(N3) > 10) && (abs(N3) < 20)) {
          error10++;
          badcount++;
          output << x1 << "," << y1 << "," << z1 << "," << N1 << "," << r1 << "," << t1 << "," <<
          x2 << "," << y2 << "," << z2 << "," << N2 << "," << r2 << "," << t2 << ","
          << x3 << "," << y3 << "," << z3 << "," << N3 << "," << r3 << "," << t3 << std::endl;
        } else if (abs(N3) > 20) {
          error20up++;
          badcount++;
          output << x1 << "," << y1 << "," << z1 << "," << N1 << "," << r1 << "," << t1 << "," <<
          x2 << "," << y2 << "," << z2 << "," << N2 << "," << r2 << "," << t2 << ","
          << x3 << "," << y3 << "," << z3 << "," << N3 << "," << r3 << "," << t3 << std::endl;
        } else {goodcount++;}
      }
    }
  }
  double percent = (double)badcount/(goodcount + badcount);
  fprintf(stderr, "Percent bad %lf\n", percent);
  fprintf(stderr, "Good %d\n", goodcount);
  fprintf(stderr, "Bad %d\n", badcount);
  fprintf(stderr, "Error between 1 and 5 %d\n", error1);
  fprintf(stderr, "Error between 5 and 10 %d\n", error5);
  fprintf(stderr, "Error between 10 and 20 %d\n", error10);
  fprintf(stderr, "Error greater than 20 %d\n", error20up);
  fprintf(stderr, "Error percent between 1 and 5 %f\n", (double)error1/(goodcount + badcount));
  fprintf(stderr, "Error percent between 5 and 10 %f\n", (double)error5/(goodcount + badcount));
  fprintf(stderr, "Error percent between 10 and 20 %f\n", (double)error10/(goodcount + badcount));
  fprintf(stderr, "Error percentgreater than 20 %f\n", (double)error20up/(goodcount + badcount));
  output.close();
  return 0;
}

void convertTimestamps(timestamps *times, actualTime *actual) {
  actual->ts_a = (unsigned long)(times->ts_a);
  actual->ts_b = (unsigned long)(times->ts_b);
  actual->ts_c = (unsigned long)(times->ts_c);
  actual->ts_d = (unsigned long)(times->ts_d);
}

void difference(detailed_crab_event *actual, crab_event *result, detailed_crab_event *diff) {
  // diff->x = (actual->x - result->x);
  // diff->y = (actual->y - result->y);
  diff->z = abs(actual->z - result->z_m);
  diff->N = abs(actual->N - result->N);
  diff->r = (actual->r - result->r_m);
  diff->theta = (actual->theta - result->theta);
}


int calcDist(double x, double y, double z, detailed_crab_event *result, timestamps *times){
  result->x = x;
  result->y = y;
  result->z = z;
  //Calculate distance
  //Line below is N
  double a = sqrt(pow((x - R),2.0) + pow((y - R),2.0) + pow(z, 2.0));
  double b = sqrt(pow((x + R),2.0) + pow((y - R),2.0) + pow(z, 2.0));
  double c = sqrt(pow((x + R),2.0) + pow((y + R),2.0) + pow(z, 2.0));
  double d = sqrt(pow((x - R),2.0) + pow((y + R),2.0) + pow(z, 2.0));
  result->N = a;

  //Time stamps
  double ts_a = a / .0015;
  double ts_b = b / .0015;
  double ts_c = c / .0015;
  double ts_d = d / .0015;
  times->ts_a = ts_a;
  times->ts_b = ts_b;
  times->ts_c = ts_c;
  times->ts_d = ts_d;
  //printTimes(times);

  //r and theta_degrees
  double radius = (double)sqrt(pow(x,2.0) + pow(y,2.0));
  double pi = (double)atan(1)*4;
  double theta_degrees = (double)atan2(y,x) * 180 / pi;
  result->r = radius;
  result->theta = theta_degrees;

  return 1;
}
