cabeese/crab-tracker/(commit log)

2018-01-28 Arduino can now read in a fith pin
2018-01-28 Arduino can now read in a fith pin see issue 21
2018-01-28 See issue 21, added John's name as author to the simulator data
    [crab_tracker_simulator.ino]
2018-02-04 See #24. Cleans up Arduino code.
    * Documentation added, including explanations
    * Bounded buffer implemented
    * Pinval/timestamp-in-parts sending implemented.
2018-02-04 See #28. WIP. Adds features in C++ (Pi) code.
    * Adds 'spi_getblock()' which gets a set of data (8 byte 'pinval'
    value, then 32-byte 'timestamp' value in 4 pieces).
    * Adds diagnostic/printing features in Pi code.
    * Adds some notes and test data to Arduino code.
    * Comments out 'Read_PIND' code for now.
2018-02-09 See #28. Moves SPI into new file.
    * SPI code in spi.h and spi.cpp
    * Makefile got a makeover
    * Future TODO: don't pass 'spifd' every time we call SPI fn
2018-02-11 See #28. Adds ability to pass a flag to the Arduino
2018-02-11 see #12, fixed some structural errors, added some debugging tools, need to figure out why im getting negative nans
    [direction.cpp]
2018-02-11 See #34. Fixes compilation issues (asside from no 'main')
    [data_collection.cpp, data_collection.h]
2018-02-13 This is the prototype GUI that we turned in for class.... There is some basic info added, as well as the paper prototypes, for context.
2018-02-14 See #34. Updates 'proc_block' and some headers.
    * Headers updated to do use include guards
    * 'proc_block' updated to correctly handle some data.
    * print statements added to ^. Delete later
    [data_collection.cpp, data_collection.h, spi.h]
2018-02-14 See #34. Adds test code and updates makefile.
    * Adds initial test case for 'proc_block'
    * Adds test code stuff to makefile. Note that the makefile is
    pretty messy right now and needs some cleanup.
2018-02-14 See #34. Fixes 'proc_block' and adds test cases
    [data_collection.cpp, test_data_collection.cpp]
2018-02-14 See #34. Adds additional test case
2018-02-15 See #34. Adds initialize() for SPI and removes 'spifd' global var
2018-02-15 See #34. Adds framework for testing SPI connection with flags
2018-02-17 See #34. Adds SPI 'test' flag and response.
    When an SPI transfer is initiated and the Pi sends the SPI_ECHO_TEST
    flag in its payload, the Arduino takes note and loads the register
    with the SPI_ECHO_RESPONSE value for the next transmission. The
    spi_getbyte() function is then called again, requesting that RESPONSE
    value from the Arduino. If this is indeed sent to the Pi, everything
    is working as intended.
2018-02-19 See #34. Adjusts test data on Arduino
2018-02-19 See #34. Adds 'util.cpp' including 'print_bin()'
2018-02-19 See #34. Fixes bounded buffer off-by-one on Arduino
    [arduino-src.ino]
2018-02-19 See #34. Misc data collection adjustments.
    Makes variables local to 'data_collection' for the time being because
    of issues with pointers passing down through multiple functions. In
    this iteration, enough data is stored locally for changes to be
    observed and printed to the screen.
    Current status:
    Pi code reads in changes and can calculate and display pings. The
    arduino seems to be passing the data along correctly as well. However,
    there are still timing errors, and sometimes the numbers jump to near
    2^32 (indicating some kind of overflow, perhaps). Where this is
    happening is TBD.
    [data_collection.cpp, data_collection.h, main.cpp]
2018-02-22 See #34. Adds 'print_bin_ulong' to utils
2018-02-22 See #34. Fixes print formatting ("%ul" -> "%lu")
    [data_collection.cpp]
2018-02-22 see #34. WIP. Test code to debug SPI
2018-02-22 see #34. WIP. Replaced function calls in Arduino with body of function.
    [arduino-src.ino]
2018-02-22 see #34. WIP. changes to Arduino code
2018-02-23 See #34. Fixes bounded buffer issue on Arduino
    Fixes issue where the "end" would wrap around to index 0, and then SPI
    would also wrap to 0 and start sending whatever was there. Of course,
    if data came in during an SPI transfer, this could lead to a race
    condition where various parts of two different records could be sent to
    the Pi, of course leading to bad data.
    [arduino-src.ino]
2018-02-23 See #34. Adds config.h and adjusts printing
    * Adds config.h which defines various program behavior. This may later
    be used for other configuration (such as hydrophone placement, water
    salinity, etc) as needed if this is deemed the best option. For now, it
    is a simple way to enable or disable "raw mode" printing.
    * Configures printing to be conditional based on the options set in
    'config.h'.
    * Adds some other print formatting.
    To enable "raw mode" (only display SPI data), set
    DISPLAY_RAW_SPI 1
    DISPLAY_PINGS 0
    For "normal mode" (only display computed pings), reverse those boolean
    values.
    [config.h, data_collection.cpp, data_collection.h, main.cpp]
2018-02-23 See #34. Cleans up Arduino code and comments
2018-02-23 See #34. Misc fixes for compiler warnings, test code
    [data_collection.cpp, main.cpp]
2018-03-01 See #14. Adds test file + updates makefile. Currently untested!
    Adds test cases that have not yet been compiled and executed
2018-03-04 See #40. Fixes Pi polling too quickly for SPI "blocks"
    Before, the Pi would request the 5 bytes (pinvals + timestamp in 4
    steps) back-to-back with no delay in between. This mean that often the
    SPI data register was not loaded with the appropriate data in time, and
    therefore corrupted data would be sent to the Pi.
    Specifically, the pinvals would get loaded into the data register at
    some point and would be ready. Then, the Pi would initiate an SPI data
    transfer and the pinvals would be sent. As soon as the last byte was
    received, the Pi would then start to request the timestamp, which is a
    32-bit unsigned long. However, the Arduino was sometimes unable to load
    this into the SPI data register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
    [spi.cpp]
2018-03-04 See #40. Updates DDRD and timestamp storing
    * Sets ALL pins to INPUT. We mask off the ones we don't use anyways, so
    it doesn't really matter if they're set to input or output, but this
    just keeps things simple.
    * Moves the storage of 'time_elapsed' into the body of an IF statement
    so that we don't have to do it every time we loop through
    [arduino-src.ino]
2018-03-07 see #12 - updated direction and test, both are working now.
    If direction.c not compiling, use “g++ -v direction.cpp” for initial
    compile. Or rewrite the max delta stuff.
2018-03-12 See #40. Store data in array of structs instead of 2 longs on Arduino
2018-03-23 See #40. Attempt to use MSB of 'pinvals' to denote stale data
    After sending a pinval, the arduino updates that pinval entry so that
    the most significant bit (unused until now) is set to a 1. When a
    change on the pins is detected and the new pinvals stored, the MSB is
    stored as a 0. This way, when the Pi reads a block of data from SPI, it
    can tell if it was a block that was sent to it previously (indicated by
    a 1 in the MSB of the `pinvals` byte). The Pi can then discard/ignore
    this data if needed.
    The motivation for this, yet to be documented, is to handle a race
    condition in which the "write" end of the buffer catches up with the
    "read" end, and new data is stored in that location as an SP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
2018-03-24 See #40. WIP. Debugging and various tests implemented; still not working
    Various changes. However, there are still issues, clearly detailed in
    comments and commit messages for issue #40.
    [arduino-src.ino, data_collection.cpp, main.cpp, spi.h]
2018-03-26 See #14. Misc fixes to test cases and code
    [test_uid.cpp, uid.cpp]
2018-03-26 See #14. Adds rounding to compensate for noise; adds related test cases
    [test_uid.cpp, uid.cpp]
2018-04-15 See #39. Adds -pedantic and -Wall to makefile; fixes 1 warning
    [main.cpp]
2018-04-26 See #40. Small Arduino cleanup; changes BB_SIZE to 64
2018-04-27 see issue #12 - updated data structure, added sound velocity function.
    [direction.cpp, direction.h]
2018-04-28 See #12. Fixes missing prototypes in direction.h
    [direction.h, test_direction.cpp]
2018-04-28 See #12. More adjustments to prototypes, structs, etc
2018-04-28 See #12. Partial work done on refactoring direction tests.
    As originally written, the tests for the direction algorithm (in
    `test_direction.cpp`) had their own copy of `triangulation_helper()`
    defined. At some point, these two functions diverged; that is, the
    version in 'direction.cpp' was different from the version in
    'test_direction.cpp'. While I have not investigated the full
    difference, one striking difference is that they each returned
    a different struct. Both structs were called `data`, but they
    had different definitions in the two files.
    The `data` struct that was used in `direction.cpp` included d, r,
    and theta. It has been renamed to `crab_event` to avoid confusion.
    The `data` stru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
    [test_direction.cpp]
2018-05-14 See #55. WIP. Adds distinct buffers for each pin. Prints stored Value.
2018-05-21 See #12. Fixes some previous changes to direction code
    [common.h, direction.cpp, test_direction.cpp]
2018-05-24 See #51. WIP. Adds matching with ID; fixes pointer stuff; adds clear()
    [data_collection.cpp]
2018-05-26 See #51. Adds clear_set() and misc noise tests
    [data_collection.cpp]
2018-05-26 See #51. Fixes polling issue
    [data_collection.cpp]
2018-05-26 See #51. WIP. Print buffer each time set is found, then clear set
2018-05-26 See #51. SPI polling delay upped to 15us. Other misc cleanup/fixes
    [main.cpp, spi.cpp]
2018-05-26 See #51. Fixes and cleanup based on @mimaxwell's comments
    [data_collection.cpp]
2018-05-26 See #56. Initial wiring diagram started
2018-05-26 See #56. Adds wiring between Pi, Arduino in figure
2018-05-28 See #12. Adds fancy printing options in config file for disp_pings
2018-05-28 See #12. Small printing cleaup. Set DISPLAY_PINGS to 15 for best results
2018-06-06 See #66. Converts timestamps to doubles representing microseconds
    * Adds the _us prefix to time-related values (including start,
    duration, etc)
    * Stores time-related values as floats instead of unsigned longs
    * Updates UID decoding to handle floats
    * SPI code expects clockcycle count and converts this to a microsecond
    value based on the #define'd clock speed of the timestamp recorder
    * Removes direction algorithm code from main loop and from compilation
    because it has not yet been updated to reflect new field names or
    'double' representations for time values
2018-06-06 See #66. Brings arduino code from timing1 branch to this branch
